YodaCh96/Reaktionsspiel/README.md

# Reaktionsspiel

## Funktionsprinzip

* Das Gerät überprüft die Reaktionszeit zweier Spieler.
* Es besitzt zwei Taster mit denen die Reaktionszeit jedes Spielers nach einem optischen Signal gemessen wird. 
* Der Spieler mit der kürzeren Reaktionszeit erhält einen Punkt. Die Punkte sind auf Anzeigen ersichtlich. Erzielt ein Spieler 9 Punkte wird ein optisches Signal ausgegeben und das Spiel ist beendet.

## Contributing

This is a personal learning project for me. Please feel free to fork this repo. Pull request to submit more programs.

## Feedback

If you find any bug or have any suggestion, please do file issues. I am graceful for any feedback and will do my best to improve this package.

## License

[MIT](LICENSE) © 2020 Ioannis Christodoulakis
