YodaCh96/Reaktionsspiel/doc/Statusbericht.md

# Statusbericht

***AP-Verantwortlicher***: Ioannis Christodoulakis, Thomas Ammann

***Datum***: 24.05.2017

## Abgeschlossen

Die Arbeitspakete «AP4. Spielerauswahl» und «AP5. Zeitmessung» wurden zusammengenommen und entwickelt. Das Zusammennehmen ermöglichte ein unkomplizierteres Entwickeln der Software. 
Der Bericht zu AP4. und AP5. ist noch nicht fertiggestellt.

## Nächste Schritte

Bis am 24.05.2017 um 18:00 Uhr wird der Bericht von AP4. und AP5. fertiggestellt.

Danach wird mit der Zusammenführung der Softwarepakete AP3. bis AP8. begonnen.

Parallel dazu wird mit der Zusammenführung der Hardwarepakete AP1. und AP2. begonnen.
