YodaCh96/Reaktionsspiel/doc/Bericht.docx

Reaktionsspiel

Gesamtdokumentation

AP-Verantwortlicher: Thomas Ammann, Ioannis Christodoulakis
Datum: 31. Mai 2017

Raumtemperatur: 24.5 °C
Revision: 01

# 1. Zusammenfassung

Es wurde, zu zweit, ein Projekt durchgeführt, in welchem ein Reaktionsspiel entwickelt wurde.

Das Reaktionsspiel vergleicht die Reaktionszeiten von zwei Spielern. Derjenige Spieler mit der kürzeren Reaktionszeit erhält einen Punkt. Auf 7-Segment-Anzeigen werden die Punktzahlen der Spieler angezeigt. Um das Spiel zu gewinnen, muss der Spieler neun Punkte erspielen.

Das Spiel wird von einem Arduino UNO Rev. 3 gesteuert. Die 7-Segment-Anzeigen werden mit BCD-UP-Counter und BCD-to-7-Segment-Converter angesteuert.

Das Projekt wurde in 10 Arbeitspakete unterteil. Diese wurden miteinander abgestimmt.
Die entworfene Feinplanung musste im Verlauf des Projektes für AP4. & AP5. erweitert werden. Dies ermöglichte eine einfachere Durchführung der beiden Arbeitspakete.

Das Projekt ist im Zeitrahmen durchgeführt worden. Die Zeitplanung konnte eingehalten werden und ist plangemäss abgeschlossen worden.

# 2. Projektgesamtziel

Das Gerät soll die Reaktionszeit zweier Spieler überprüfen. Es besitzt zwei Taster mit denen die Reaktionszeit jedes Spielers nach einem optischen Signal gemessen wird. Der Spieler mit der kürzeren Reaktionszeit erhält einen Punkt. Die Punkte sind auf Anzeigen ersichtlich. Erzielt ein Spieler 9 Punkte wird ein optisches Signal ausgegeben und das Spiel ist beendet. Das Gerät soll spielfähig aufgebaut sein. Das Projekt soll am 28.06.2017 fertiggestellt sein.

# 3. Grobplanung

Projektstruktur
Teilziel | Arbeitspakete | Aufwand
| | Schätzung | | Ist
| | Tag/e | Datum | Tag/e | Datum
Grobplanung | | ½ | 09.05.2017 | ½ | 10.05.2017
Feinplanung | | 1 | 10.05.2017 | ½ | 10.05.2017
Hardware | AP1. Eingabe | ½ | 15.05.2017 | ½ | 15.05.2017
| AP2. Ausgabe | 2 | 16.05.2017 | 1 | 16.05.2017
Software | AP3. Start | ½ | 17.05.2017 | ¼ | 17.05.2017
| AP4. Spielerauswahl | ½ | 17.05.2017 | ½ | 22.05.2017
| AP5. Zeitmessung | 2 | 23.05.2017 | ½ | 22.05.2017
| AP6. Zeitmessung-Auswertung | 1 | 23.05.2017 | ¼ | 17.05.2017
| AP7. Spielende | ½ | 24.05.2017 | ¼ | 17.05.2017
| AP.8 Neustart | ½ | 24.05.2017 | ¼ | 17.05.2017
Zusammen-Führung | AP9. Gesamtprogramm | 1 | 29.05.2017 | ½ | 29.05.2017
| AP10. Gesamt-Hardware | 1 | 29.05.2017 | ½ | 29.05.2017
| Anpassungen | 2 | / | ½ | 29.05.2017
Bericht | Gesamtdokumentation | 2 | 31.05.2017 | 2 | 31.05.2017

# 4. Feinplanung

## 4.1 Funktionsprinzip

Start

Zum Starten wird die Start-Taste gedrückt. Die Lampen der Spieler blinken drei Mal auf.

Spielerauswahl

Zu Beginn jeder Runde wird zufällig ein Spieler gewählt, welcher beginnt. Danach kommt der andere Spieler.

Es darf nicht gezeigt werden welcher Spieler beginnt!

Zeitmessung

Zufällig nach zwei bis sechs Sekunden beginnt die Zeitmessung. Das Aufleuchten einer Lampe signalisiert dem Spieler den Messungsstart. Dieser soll nun so schnell als möglich seine Taste drücken. Mit dem Drücken der Taste wird die Zeitmessung gestoppt.
Dieser Vorgang wird mit dem anderen Spieler wiederholt.

Auswertung

Die gemessenen Reaktionszeiten der Spieler werden verglichen. Der Spieler mit der kleineren Reaktionszeit erhält einen Punkt.

Spielende

Wenn ein Spieler neun Punkte erhält ist das Spiel beendet. Die Lampe des Gewinners blinkt.

Neustart

Zum Neustarten wird die Start-Taste gedrückt. Die Punkte werden zurückgesetzt.
Das Spiel kann nur nach Spielende neu gestartet werden.

## 4.2 Festlegungen

Hardwarefestlegungen

- Das Reaktionsspiel wird mit einem Arduino Uno gesteuert.
- Die Speisespannung beträgt 4.5V DC.

Softwarefestlegungen

- Die Namen des Begriffsverzeichnisses müssen verwendet werden.
- Das gesamte Programm muss kleiner als 32kByte sein.

## 4.3 Anforderungskatalog

### 4.3.1 Hardware

Arbeitspaket 1: Eingabe

Vorgaben:
Es soll für beide Spieler ein Taster zur Quittierung zur Verfügung stehen.
Mit einem Taster soll das Gerät gestartet bzw. zurückgesetzt werden.

Schnittstelleninformationen:

Speisung | Eingabe | Ausgabe
| Quittierungs-Impuls1 | Quittierungs-Signal1
4.50V DC | Quittierungs-Impuls2 | Quittierungs-Signal2
| Start-Impuls | Start-Signal

Arbeitspaket 2: Ausgabe

Vorgaben:
Die Punktzahlen der Spieler sollen auf Anzeigen ersichtlich sein.
Jeder Spieler besitzt eine optische Meldung, die den Beginn der Zeitmessung signalisiert.
Jeder Spieler besitzt eine optische Meldung, die signalisiert, wer gewonnen hat.

Erweiterungen:
Die Punktzahl der Spieler wird aus je einem Controllerausgang bestimmt.
Die Punktzahlen werden einstellig ausgegeben.

Schnittstelleninformationen:

Speisung | Eingabe | Ausgabe
| Punktzahl-Signal1 | Punktzahl1
| Punktzahl-Signal2 | Punktzahl2
4.50V DC | Optische-Meldung-Signal1 | Optische Meldung1
| Optische-Meldung-Signal2 | Optische Meldung2
| Reset-Signal (aktiv LOW)

### 4.3.2 Software

Arbeitspaket 3: Start

Vorgaben:
Zum Starten wird ein Start-Signal benötigt. Wenn das Programm startet soll ein optisches Start-Signal auftreten. Dieses Blinkt drei Mal.

Schnittstelleninformationen:

Eingabe | Ausgabe
Start-Signal | Optische Meldung1
| Optische Meldung2

Arbeitspaket 4: Spielerauswahl

Vorgaben:
Zu Beginn jeder Runde wird zufällig ein Spieler gewählt, welcher beginnt. Danach kommt der andere Spieler.

Schnittstelleninformationen:

Eingabe | Ausgabe
/ | /

Arbeitspaket 5: Zeitmessung

Vorgaben:
Die Reaktionszeit wird zwischen dem optischen Zeitmessung-Start-Signal und dem Quittierungs-Signal gemessen.

Erweiterungen:
Um die Reaktion richtig zu testen wird die Reaktionszeitmessung zufällig 1 bis 5 Sekunden verspätet gestartet.

Schnittstelleninformationen:

Eingabe | Ausgabe
Quittierungs-Signal1 | Reaktionszeit1
| Reaktionszeit2
Quittierungs-Signal2 | Optische Meldung1
| Optische Meldung2

Arbeitspaket 6: Zeitmessung-Auswertung

Vorgaben:
Die Reaktionszeiten der Spieler werden verglichen. Der Spieler mit der kürzeren Reaktionszeit erhält einen Punkt.

Erweiterungen:
Die Punktzahl der Spieler wird aus je einem Controllerausgang bestimmt. Das Punktzahl- Signal ist ein HIGH-Impuls, welcher auftritt, wenn um die Punktzahl um einen Punkt erhöht werden soll.

Schnittstelleninformationen:

Eingabe | Ausgabe
Reaktionszeit1 | Punktzahl-Signal1
| Punktzahl-Signal2
Reaktionszeit2 | Punktzahl1
| Punktzahl2

Arbeitspaket 7: Spielende

Vorgaben:
Das Spiel ist beendet, sobald ein Spieler neun Punkte erhalten hat. Die optische Meldung «Gewinner» des Spielers geht an.

Erweiterungen:
Die optische Meldung «Gewinner» soll leuchten. Wenn die optische Meldung «Gewinner» ausgegeben wird soll ist Spielende abgeschlossen.

Schnittstelleninformationen:

Eingabe | Ausgabe
Punktzahl-Signal1 | Optische Meldung1
Punktzahl-Signal2 | Optische Meldung2

Arbeitspaket 8: Neustart

Vorgaben:
Nachdem das Spiel beendet wurde, kann das dieses mit einem Start-Signal zurückgesetzt werden.

Schnittstelleninformationen:

Eingabe | Ausgabe
Punktzahl1 | Reset-Signal (aktiv LOW)
| Punktzahl-Signal1
Punktzahl2 | Punktzahl-Signal2
| Optische Meldung1
| Optische Meldung2

### 4.3.3 Zusammenführung

Arbeitspaket 9: Gesamtprogramm

Vorgaben:
Die AP3. Bis AP6. werden zum Gesamtprogramm zusammengeführt.
Das Programm soll wie in der Funktionsbeschreibung ablaufen.
(siehe «Funktionsbeschreibung»)

Schnittstelleninformationen:

Eingabe | Ausgabe
Quittieruns-Signal1 | Punktzahl-Signal1
Quittieruns-Signal2 | Punktzahl-Signal2
Start-Signal | Optische Meldung1
| Optische Meldung2
| Reset-Signal (aktiv LOW)

Arbeitspaket 10: Gesamt-Hardware

Vorgaben:
Die gesamte Hardware soll zusammengeführt werden.

Schnittstelleninformationen:

Eingabe | Ausgabe
Quittierungs-Impuls1 | Quittierungs-Signal1
Quittierungs-Impuls2 | Quittierungs-Signal2
Start-Impuls | Start-Signal
Punktzahl-Signal1 | Punktzahl1
Punktzahl-Signal2 | Punktzahl2
Optische-Meldung-Signal1 | Optische Meldung1
Optische-Meldung-Signal2 | Optische Meldung2
Reset-Signal (aktiv LOW)

### 4.3.4 Erweiterung Arbeitspaket 4. und Arbeitspaket 5.

Um das Arbeitspaket 4 und das Arbeitspaket 5 miteinander abzustimmen, wurden die Schnittstelleninformationen erweitert.

Arbeitspaket 4: Spielerauswahl

Eingabe | Ausgabe
| Spieler1
| Spieler2
/ | Zeitmessungstart1
| Zeitmessungstart2
| EingangSpieler1
| EingangSpieler2

Variable | Speicher-Name
Spieler1 | Spieler[0]
Spieler2 | Spieler[1]
Zeitmessungstart1 | Zms[0]
Zeitmessungstart2 | Zms[1]
EingangSpieler1 | EingangSpieler[0]
EingangSpieler2 | EingangSpieler[1]

Arbeitspaket 5: Zeitmessung

Eingabe | Ausgabe
Quittierungs-Signal1 | Reaktionszeit1
Quittierungs-Signal2
Zeitmessungstart1 | Reaktionszeit2
Zeitmessungstart2
EingangsSpieler1 | Optische Meldung1
EingangsSpieler2
Spieler1 | Optische Meldung2
Spieler2

Variable | Speicher-Name
Spieler1 | Spieler[0]
Spieler2 | Spieler[1]
Zeitmessungstart1 | Zms[0]
Zeitmessungstart2 | Zms[1]
EingangSpieler1 | EingangSpieler[0]
EingangSpieler2 | EingangSpieler[1]

### 4.3.5 Begriffsverzeichnis

Eingabe | Speicher-Name | Pin-Name | Pin | Datentyp
Start-Signal | St_Si | S_S | 3 | bool
Quittieruns-Signal1 | Qu_Si1 | Q_S1 | 4 | char
Quittieruns-Signal2 | Qu_Si2 | Q_S2 | 5 | char

Ausgabe | Speicher-Name | Pin-Name | Pin | Datentyp
Punktzahl-Signal1 | Pu_Si1 | P_S1 | 6 | char
Punktzahl-Signal2 | Pu_Si2 | P_S2 | 7 | char
Optische Meldung1 | Op_Me1 | O_M1 | 8 | char
Optische Meldung2 | Op_Me2 | O_M2 | 9 | char
Reset-Signal (aktiv LOW) | Re_Si | R_S | 10 | char

Variable | Speicher-Name | Datentyp
Punktzahl1 | Pu_Za1 | char
Punktzahl2 | Pu_Za2 | char
Reaktionszeit1 | Re_Ze1 | char
Reaktionszeit2 | Re_Ze2 | char
Spieler1 | Spieler[0] | char
Spieler2 | Spieler[1] | char
Zeitmessungstart1 | Zms[0] | char
Zeitmessungstart2 | Zms[1] | char
EingangSpieler1 | EingangSpieler[0] | char
EingangSpieler2 | EingangSpieler[1] | char

# 5. Arbeitspakete

## 5.1 Arbeitspaket 1: Eingabe

### 5.1.1 Zusammenfassung

Es wurde eine funktionsfähige Schaltung zur Erzeugung dreier digitaler Signale entwickelt. Mit einem Tastendruck wird das jeweilige Signal logisch HIGH.

### 5.1.2 Aufgabenstellung

Der physikalische Druck soll in eine digitale Spannung umgewandelt werden. Es soll für beide Spieler ein Taster zur Quittierung zur Verfügung stehen. Mit einem Taster soll das Gerät gestartet werden.

### 5.1.3 Vorgaben

Schnittstelleninformationen
Speisung: 5V DC
Eingänge: Quittierungs-Impuls (Spieler1 und Spieler2, Druck), Start-Signal (Druck)
Ausgänge: Quittierungs-Signale (Spieler1 und Spieler2),
Start-Signal

### 5.1.4 Blockschaltbild

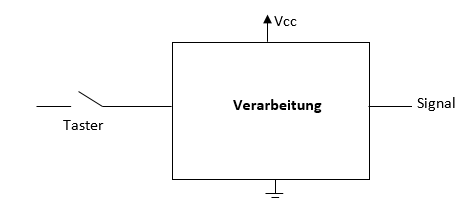
[picture p1: figure]

Start-Signal

Quittierungs-Signal 1

Quittierungs-Signal 2

Quittierungs-Impuls1

Quittierungs-Impuls2

Start-Signal (Druck)

Abbildung 1, Blockschaltbild

### 5.1.5 Lösungsansätze

Mit einem Taster und einem Pull-Down-Widerstand wird die digitale Spannung erzeugt.

### 5.1.6 Berechnungen

Gegebene Werte:

V_(cc) = 5.00V

R_1 = R_2 =R_3 = 10.0kΩ

Berechnungen:

I_(Max.AM1) =(3*V_(cc))/(R_1)=(3*5V)/(10kΩ)= 1.50 mA

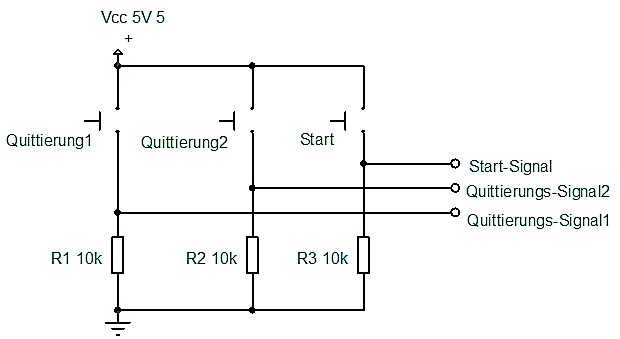
[picture p2: figure]

### 5.1.7 Schaltung

Abbildung 2, Schaltung

Es wurde die obige Schaltung entwickelt. (Abb.2)

### 5.1.8 Messungen

Abbildung 3, Messschaltung

Quittierung1 | Quittierung2 | Start | AM1 in mA | VM1 in V | VM2 in V | VM3 in V
0 | 0 | 0 | 0.01 | 0 | 0 | 0
gedrückt | 0 | 0 | 0.51 | 5 | 0 | 0
0 | gedrückt | 0 | 0.50 | 0 | 5 | 0
0 | 0 | gedrückt | 0.50 | 0 | 0 | 5
gedrückt | gedrückt | gedrückt | 1.52 | 5 | 5 | 5

### 5.1.9 Verwendete Geräte

Multimeter: Agilent U1242A, BERUF Zug 03542

Speisegerät: DC Power Supply DF1730SB3A, BERUF Zug 03460

Breadboard: Besitzer Thomas Ammann

### 5.1.10 Schlussfolgerung

Es wurde eine funktionsfähige Schaltung entwickelt.

Die Ausgänge sind logisch LOW bis der jeweilige Taster gedrückt wird. Dabei wird der Ausgang logisch HIGH.

## 5.2 Arbeitspaket 2: Ausgabe

### 5.2.1 Zusammenfassung

Es wurde eine Schaltung entwickelt, welche die Punkzahlen der Spieler 1 und 2 auf je einer
7-Segmentanzeigen anzeigt. Mit zwei LEDs werden die optische Signale der Spieler angezeigt.

### 5.2.2 Aufgabenstellung

Es muss eine Teilschaltung entwickelt werden, die die Punktzahlen der Spieler 1 und 2 auf Anzeigen anzeigt. Jeder Spieler besitzt eine optische Meldung, die den Beginn der Zeitmessung signalisiert. Jeder Spieler besitzt eine optische Meldung, die signalisiert, wer gewonnen hat.

### 5.2.3 Vorgaben

Erweiterungen:
Die Punktzahl der Spieler wird aus je einem Controllerausgang bestimmt.
Die Punktzahlen werden einstellig ausgegeben.

Schnittstelleninformationen:
Speisung: 5V DC
Eingänge: Punktzahl-Signale (Spieler1 und Spieler2),
Zeitmessung-Start-Signale (Spieler1 und Spieler2),
Gewinner-Signale (Spieler1 und Spieler2),
Beginn-Signal (Spieler1 und Spieler2), Reset-Signal
Ausgänge: Punktzahlen (einstellig, Spieler1 und Spieler2),
optische Meldungen für «Zeitmessung-Start» (Spieler1 und Spieler2),
optische Meldungen für «Gewinner» (Spieler1 und Spieler2),
optisches Beginn-Signal (Spieler1 und Spieler2)

### 5.2.4 Blockschaltbild

optische Meldung Spieler 1

Vcc 5V

PZ-Signal Spieler 2

PZ-Signal Spieler 1

Verarbeitung

ZS-Signal Spieler 2

ZS-Signal Spieler 1

Punktzahl Spieler 1

GW-Signal Spieler 2

GW-Signal Spieler 1

Beginn-Signal Spieler 2

Beginn-Signal Spieler 1

Punktzahl Spieler 2

Reset-Signal

optische Meldung Spieler 2

- ZS-Signale Spieler 1,2: Zeitmessung-Start-Signale Spieler 1,2
- PZ-Signale Spieler 1,2: Punktzahl-Signale Spieler 1,2
- GW-Signale Spieler 1,2: Gewinner-Signale Spieler 1,2

### 5.2.5 Berechnungen

Für LEDs müssen immer Vorwiderstände verwendet werden, welche dafür sorgen, dass an der LED nur die zulässige Spannung anliegt. Durch diese Vorwiderstände wird auch der Strom I durch die LEDs begrenzt, sodass den Strom nicht über den maximalen zulässigen Strom der LED ansteigt. Für I nehme ich in meinen Berechnungen den Erfahrungswert 7mA.

Kennwerte der roten LED:

UF = 2.1V (Datenblatt, Quellenverzeichnis)

I = 7mA (Erfahrungswert)

*¹U0 (Speisung)= 5V (Vorgabe)

R_(1,2) = (U_0 - U_F)/I= (5V-2.1V)/(7mA)= 414Ω

Aus unserer E-24 Widerstandsreihe haben wir einen R1,2=430 Ω gewählt.

I= (U_0 - U_F)/(R_V)= (5V-2.1V)/(430 Ω)= 6.74 mA

*¹ 5V Betriebsspannung von Arduino UNO Rev.3

Pull-Down Widerstände:

Da recht hohe Frequenzen zum Einsatz kommen die sich in unmittelbarer Nähe der Eingänge befinden ist es notwendig diese Eingänge mit einem definierten Potential zu versehen. Klassischer Weise wird ein Widerstand verwendet, welcher zum Beispiel auf Masse gelegt wird. Ein so genannter Pull Down Widerstand. Ich habe für Pull-down Widerstände R17=R18=R19=10kΩ entschieden.

Vorwiderstände 7-Segment-Anzeige:

U’F = 2.1V (Datenblatt, Quellenverzeichnis)

I’ = 5mA (Erfahrungswert)

*¹U0 (Speisung)= 5V (Vorgabe)

R_(3-16) = (U_0 - U'_F)/(I')= (5V-2.1V)/(5mA)= 580Ω

Aus unserer E-24 Widerstandsreihe haben wir einen R3-16=620 Ω gewählt.

I'= (U_0 - U'_F)/(R_(3-16))= (5V-2.1V)/(620 Ω)= 4.67 mA

### 5.2.6 Schaltung

### 5.2.7 Messung

Clock-Signal | 7-Segment Zahl Spieler 1 | 7-Segment Zahl Spieler 2
0 | 0 | 0
1 | 1 | 1
0 | 1 | 1
1 | 2 | 2
0 | 2 | 2
1 | 3 | 3
0 | 3 | 3
1 | 4 | 4
0 | 4 | 4
1 | 5 | 5
0 | 5 | 5
1 | 6 | 6
0 | 6 | 6
1 | 7 | 7
0 | 7 | 7
1 | 8 | 8
0 | 8 | 8
1 | 9 | 9
0 | 9 | 9
1 | 0 | 0

### 5.2.8 Verwendete Geräte und Elektrokomponente

Digitrainer 6 BERUF Zug 00878 | 2x 7-Segment Anzeigen | 2x BCD-Decoder 74HC4511
2x LEDs rot 5mm | 2x 74HC162 | 3x Taster
2x R1=R2=430Ω | 14x R3-R16=620Ω | 3x Pull-Down Widerstände R17-R19=10kΩ

### 5.2.9 Schlussfolgerung

Die entwickelte Schaltung erfüllt die Vorgaben (siehe 3. Vorgaben/Seite 14).
Sie wurde mit einem Digitrainer komplett getestet.

## 5.3 Arbeitspaket 3: Start

### 5.3.1 Zusammenfassung

Es wurde ein Software-Programm entwickelt, welches ein Start-Signal benötigt. Wenn das Programm startet, blinken zwei LEDs drei Mal.

### 5.3.2 Aufgabenstellung

Zum Starten wird ein Start-Signal benötigt. Wenn das Programm startet soll ein optisches Start-Signal auftreten. Dieses Blinkt drei Mal.

Schnittstelleninformationen
Eingänge: Start-Signal (aktiv LOW)
Ausgänge: Beginn-Signal (Spieler1 und Spieler2)

### 5.3.3 Begriffsverzeichnis

Eingabe | Speicher-Name | Pin-Name | Pin
Start-Signal | St_Si | S_S | 3

Ausgabe | Speicher-Name | Pin-Name | Pin
Optische Meldung1 | Op_Me1 | O_M1 | 8
Optische Meldung2 | Op_Me2 | O_M2 | 9

### 5.3.4 Struktogramm

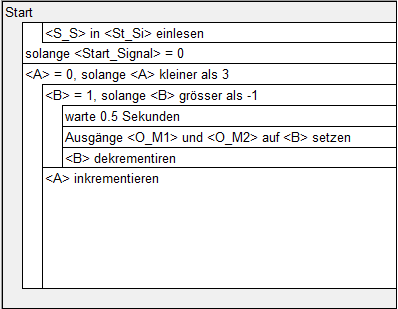
[picture p3: figure]

Abbildung 2, Struktogramm

### 5.3.5 Programm–Code

Um eine Variable zu erstellen, müssen wir diese zuerst deklarieren. Wir haben für die Variablen
Start-Signal, A und B den Datentyp char gewählt, da die Variablen nicht mehr Speicherplatz benötigen (1 Byte).

bool St_Si ; // Variablen

char A,

B;

Die Pin-Nummern der Ein- und Ausgänge sind den Pin-Namen gespeichert. Diese sind unveränderbar.

const char S_S = 3, // Konstanten

O_M1 = 8,

O_M2 = 9;

setup() wird einmalig beim Einschalten des Arduino ausgeführt. Dort definieren wir mit der Funktion pinMode(), ob die digitalen Pins Ein- oder Ausgänge sind.

void setup() { // I/O

pinMode (S_S, INPUT); // Eingaenge

pinMode (O_M1, OUTPUT); // Ausgaenge

pinMode (O_M2, OUTPUT);

}

loop() wird wiederholt ausgeführt. In der Funktion wird das Hauptprogramm ausgeführt.
Die do-while-Schleife liest den Digitalwert am Eingang «S_S» ein und speichert ihn in «St_Si». Danach wartet das Programm 50ms, bevor es überprüft, ob «St_Si» 0 entspricht. Trifft dies zu, wird die Schleife wiederholt.

void loop() { // Hauptprogramm

do { // Start-Signal einlesen

St_Si = digitalRead(S_S);

delay (50);

} while (St_Si == 0);

Die erste for-Schleife wird dreimal durchgeführt. Die zweite Schleife wird zweimal durchgeführt. Im erstem Durchlauf werden die Ausgänge «O_M1» und «O_M2» eingeschaltet. Im zweiten Durchlauf werden diese ausgeschaltet. Die delay()–Funktion lässt den Arduino die Ausführung des Programms für eine gewisse Zeitspanne anhalten. Damit wird der Logikwechsel der Ausgänge verlangsamt.

for (A = 0; A < 3; A++) { // Optische Meldung

for (B = 1; B > -1; B--) {

delay (500);

digitalWrite (O_M1, B);

digitalWrite (O_M2, B);

}

}

}

### 5.3.6 Schlussfolgerung

Das entwickelte Software-Programm erfüllt die Anforderungen der Aufgabenstellung.
(2. Aufgabenstellung/Seite 19).

## 5.4 Arbeitspaket 4: Spielerauswahl

### 5.4.1 Zusammenfassung

Es wurde ein Software-Programm entwickelt, welches zufällig einen Spieler wählt. Dieser beginnt die Runde.

### 5.4.2 Aufgabenstellung

Zu Beginn jeder Runde wird zufällig ein Spieler gewählt, welcher beginnt. Danach kommt der andere Spieler.

Schnittstelleninformationen

Eingabe | Ausgabe
/ | Spieler1
/ | Spieler2
/ | Zeitmessungstart1
/ | Zeitmessungstart2
/ | EingangSpieler1
/ | EingangSpieler2

Begriffserklärung

Variable | Speicher-Name
Spieler1 | Spieler[0]
Spieler2 | Spieler[1]
Zeitmessungstart1 | Zms[0]
Zeitmessungstart2 | Zms[1]
EingangSpieler1 | EingangSpieler[0]
EingangSpieler2 | EingangSpieler[1]

### 5.4.3 Struktogramm

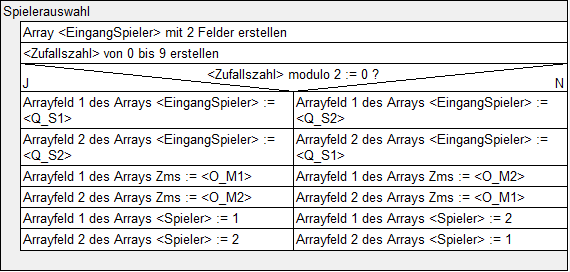
[picture p4: figure]

### 5.4.4 Programm–Code

Um eine Variable zu erstellen, müssen wir diese zuerst deklarieren. Wir haben für die Variablen
den Datentyp char gewählt, da die Variablen nicht mehr Speicherplatz benötigen (1 Byte).

char EingangSpieler[2], // Variablen

Zms[2],

Spieler[2];

unsigned long Zufallszahl;

Die Pin-Nummern der Ein- und Ausgänge sind den Pin-Namen gespeichert. Diese sind unveränderbar.

const char Q_S1 = 4, // Konstanten

Q_S2 = 5,

O_M1 = 8,

O_M2 = 9;

setup() wird einmalig beim Einschalten des Arduino ausgeführt. Mit der Funktion randomSeed() wird der Analogeingang definiert, welcher für die Erstellung des «zufälligen» Werts verwendet wird. Dieser Eingang muss logisch unbestimmt sein, darf also nicht angeschlossen sein.

void setup() { // I/O

randomSeed(analogRead(0)); // Der analog-Input 0 darf nicht angeschlossen werden.

}

loop() wird wiederholt ausgeführt. In der Funktion wird das Hauptprogramm ausgeführt.
Die Funktion random() generiert einen «zufälligen» Wert von 0 bis 99. Dieser wird in «Zufallszahl» gespeichert. Mit der Variable «Zufallszahl» wird einem modulo-2-Rechnung durchgeführt. Ist das Ergebnis 0 beginnt Spieler 1. Ist das Ergebnis 1 beginnt Spieler 2.

void loop() { // Hauptprogramm

Zufallszahl = random(100);

if(Zufallszahl % 2 == 0){ // Auswertung

EingangSpieler[0] = Q_S1;

EingangSpieler[1] = Q_S2;

Zms[0] = O_M1;

Zms[1] = O_M2;

Spieler[0] = 1;

Spieler[1] = 2;

}

else{

EingangSpieler[0] = Q_S2;

EingangSpieler[1] = Q_S1;

Zms[0] = O_M2;

Zms[1] = O_M1;

Spieler[0] = 2;

Spieler[1] = 1;

}

}

### 5.4.5 Schlussfolgerung

Das entwickelte Software-Programm erfüllt die Anforderungen der Aufgabenstellung
(2. Aufgabenstellung/Seite 21).

## 5.5 Arbeitspaket 5: Zeitmessung

### 5.5.1 Zusammenfassung

Es wurde ein Software-Programm entwickelt, welches die Reaktionszeit der beiden Spieler misst.

### 5.5.2 Aufgabenstellung

Die Reaktionszeit wird zwischen dem optischen Zeitmessung-Start-Signal und dem Quittierungs-Signal gemessen.

Um die Reaktion richtig zu testen wird die Reaktionszeitmessung zufällig 1 bis 5 Sekundenverspätet gestartet.

Schnittstelleninformationen

Eingabe | Ausgabe
Quittierungs-Signal1 | Reaktionszeit1
Quittierungs-Signal2 | Reaktionszeit2
Zeitmessungstart1 | Optische Meldung1
Zeitmessungstart2 | Optische Meldung2
EingangsSpieler1
EingangsSpieler2
Spieler1
Spieler2

Begriffserklärung

Variable | Speicher-Name
Spieler1 | Spieler[0]
Spieler2 | Spieler[1]
Zeitmessungstart1 | Zms[0]
Zeitmessungstart2 | Zms[1]
EingangSpieler1 | EingangSpieler[0]
EingangSpieler2 | EingangSpieler[1]
Reaktionszeit1 | Re_Ze1
Reaktionszeit2 | Re_Ze2

Eingabe | Speicher-Name | Pin-Name | Pin
Quittieruns-Signal1 | Qu_Si1 | Q_S1 | 4
Quittieruns-Signal2 | Qu_Si2 | Q_S2 | 5

Ausgabe | Speicher-Name | Pin-Name | Pin
Optische Meldung1 | Op_Me1 | O_M1 | 8
Optische Meldung2 | Op_Me2 | O_M2 | 9

### 5.5.3 Struktogramm

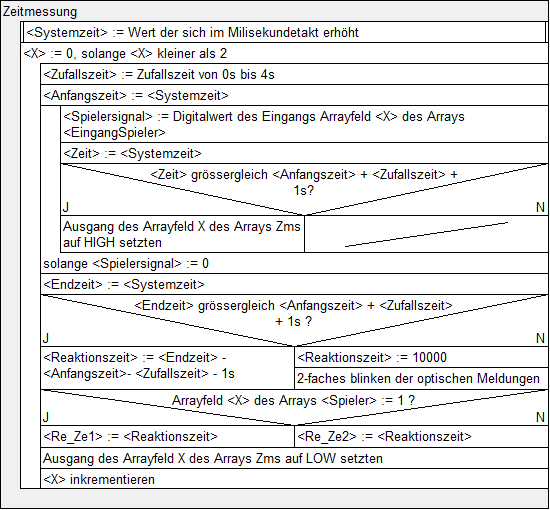
[picture p5: figure]

### 5.5.4 Programm – Code

Zunächst werden die Variablen definiert.

char X, // Variablen

Spielersignal,

Zms[2], // Zeitmessungstart

Spieler[2];

int Zufallszeit,

Re_Ze1,

Re_Ze2;

unsigned long Anfangszeit, // Anfangszeit der Zeitmessung

Endzeit, // Endzeit der Zeitmessung

Zeit;

Die Pin-Nummern der Ein- und Ausgänge sind den Pin-Namen gespeichert. Diese sind unveränderbar.

const char Q_S1 = 4, // Konstanten

Q_S2 = 5,

O_M1 = 8,

O_M2 = 9;

setup() wird einmalig beim Einschalten des Arduino ausgeführt. Dort definieren wir mit der Funktion pinMode(), ob die digitalen Pins Ein- oder Ausgänge sind. Mit der Funktion randomSeed() wird der Analogeingang definiert, welcher für die Erstellung des «zufälligen» Werts verwendet wird. Dieser Eingang muss logisch unbestimmt sein, darf also nicht angeschlossen sein.

void setup() { // I/O

pinMode(Q_S1, INPUT); // Eingaenge

pinMode(Q_S2, INPUT);

pinMode(O_M1, OUTPUT); // Ausgaenge

pinMode(O_M2, OUTPUT);

randomSeed(analogRead(0)); // Der analogInput 0 darf nicht angeschlossen werden.

}

loop() wird wiederholt ausgeführt. In der Funktion wird das Hauptprogramm ausgeführt.
Die for-Schleife wird zweimal durchgeführt. Die Funktion random() erzeugt einen «zufälligen» Wert von 0 bis 4000. Die Funktion millis() erzeugt einen Wert, welcher jede Millisekunde inkrementiert wird. «Anfangszeit» entspricht dem Wert von millis().

void loop() { // Hauptprogramm

for(X = 0; X < 2; X++){ // Auswertung

Zufallszeit = random(4001);

Anfangszeit = millis();

«Zeit» entspricht dem aktuellen Wert von millis(). Die if-Verzweigung prüft, ob «Zeit» grössergleich «Anfangszeit» + «Zufallszeit» + 1000 entspricht. Trifft dies zu wird ein Zeitmessungsstart-Signal ausgegeben. Die do-while-Schleife wird wiederholt solange «Spielersignal» 0 entspricht. Danach wird der Wert von millis() «Endzeit» zugeordnet.

do{

Spielersignal = digitalRead(EingangSpieler[X]);

Zeit = millis();

if(Zeit >= Anfangszeit + Zufallszeit + 1000){

digitalWrite(Zms[X], HIGH);

}

}while(Spielersignal == 0);

Endzeit = millis();

Die if-Verzweigung prüft, ob «Endzeit» grössergleich «Anfangszeit» + «Zufallszeit» + 1000. Trifft dies zu wird die Reaktionszeit ausgerechnet und in «Reaktionszeit» gespeichert. Trifft der Vergleich nicht zu wird «Reaktionszeit» auf 10000 (10s) gesetzt. Dabei werden zwei optische Signale ausgegeben.

if(Endzeit >= Anfangszeit + Zufallszeit + 1000){

Reaktionszeit = Endzeit - Anfangszeit - Zufallszeit - 1000;

}

else{

Reaktionszeit = 10000;

digitalWrite(O_M1, HIGH);

digitalWrite(O_M2, HIGH);

delay(300);

digitalWrite(O_M1, LOW);

digitalWrite(O_M2, LOW);

delay(300);

digitalWrite(O_M1, HIGH);

digitalWrite(O_M2, HIGH);

delay(300);

digitalWrite(O_M1, LOW);

digitalWrite(O_M2, LOW);

}

Die if-Verzweigung prüft welchem Spieler «Reaktionszeit» zuzuordnen ist und speichert diese in die entsprechende Variable. Danach wird das Zeitmessungsstart-Signal auf logisch LOW gesetzt.

if(Spieler[X] = 1){

Re_Ze1 = Reaktionszeit;

}

else{

Re_Ze2 = Reaktionszeit;

}

digitalWrite(Zms[X], LOW);

}

}

### 5.5.5 Schlussfolgerung

Das entwickelte Software-Programm erfüllt die Anforderungen der Aufgabenstellung.

## 5.6 Arbeitspaket 6: Zeitmessung-Auswertung

### 5.6.1 Zusammenfassung

Es wurde ein Software-Programm entwickelt, welches die Reaktionszeiten zweier Spieler vergleicht und auswertet. Derjenige Spieler mit der kleineren Reaktionszeit erhält einen Punkt.

### 5.6.2 Aufgabenstellung

Die Reaktionszeiten der Spieler werden verglichen. Der Spieler mit der kürzeren Reaktionszeit erhält einen Punkt.

Die Punktzahl der Spieler wird aus je einem Controllerausgang bestimmt. Das Punktzahl-Signal ist ein HIGH-Impuls, welcher auftritt, wenn die Punktzahl um einen Punkt erhöht werden soll.

Schnittstelleninformationen

Eingabe | Ausgabe
Reaktionszeit1 | Punktzahl-Signal1
Reaktionszeit2 | Punktzahl-Signal2
| Punktzahl1
| Punktzahl2

Begriffserklärung

Variable | Speicher-Name
Punktzahl1 | Pu_Za1
Punktzahl2 | Pu_Za2
Reaktionszeit1 | Re_Ze1
Reaktionszeit2 | Re_Ze2

Ausgabe | Speicher-Name | Pin-Name | Pin
Punktzahl-Signal1 | Pu_Si1 | P_S1 | 6
Punktzahl-Signal2 | Pu_Si2 | P_S2 | 7

### 5.6.3 Struktogramm

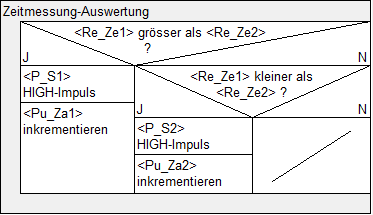
[picture p6: figure]

### 5.6.4 Programm–Code

Zunächst werden die Variablen definiert.

int Re_Ze1, // Variablen

Re_Ze2 ;

char Pu_Za1 = 0,

Pu_Za2 = 0 ;

Die Pin-Nummern der Ein- und Ausgänge sind den Pin-Namen gespeichert. Diese sind unveränderbar.

const char P_S1 = 6, // Konstanten

P_S2 = 7;

setup() wird einmalig beim Einschalten des Arduino ausgeführt. Dort definieren wir mit der Funktion pinMode(), ob die digitalen Pins Ein- oder Ausgänge sind.

void setup() { // I/O

pinMode(P_S1, OUTPUT); // Ausgaenge

pinMode(P_S2, OUTPUT);

}

loop() wird wiederholt ausgeführt. In der Funktion wird das Hauptprogramm ausgeführt.
Die if-Verzweigung prüft, ob «Re_Ze1» grösser als «Re_Ze2» ist. Trifft dies zu wird ein Punktzahl-Signal ausgegeben und die Punktzahl des ersten Spielers wird inkrementiert. Die else-if-Verzweigung prüft, ob «Re_Ze1» kleiner als «Re_Ze2» ist. Trifft dies zu wird ein Punktzahl-Signal ausgegeben und die Punktzahl des zweiten Spielers wird inkrementiert.

void loop() { // Hauptprogramm

if(Re_Ze1 > Re_Ze2){ // Auswertung

digitalWrite(P_S1, HIGH);

delay(10);

digitalWrite(P_S1, LOW);

Pu_Za2++;

}

else if(Re_Ze1 < Re_Ze2){

digitalWrite(P_S2, HIGH);

delay(10);

digitalWrite(P_S2, LOW);

Pu_Za1++;

}

### 5.6.5 Schlussfolgerung

Das entwickelte Software-Programm erfüllt die Anforderungen der Aufgabenstellung
(2. Aufgabenstellung/Seite 29).

## 5.7 Arbeitspaket 7: Spielende

### 5.7.1 Zusammenfassung

Es wurde ein Software-Programm entwickelt, welches das Spielende auswertet. Das Programm gibt eine optische Meldung aus, wenn ein Spieler neun Punkte erhält.

### 5.7.2 Aufgabenstellung

Das Spiel ist beendet, sobald ein Spieler neun Punkte erhalten hat. Die optische Meldung «Gewinner» des Spielers geht an.

Schnittstelleninformationen
Die optische Meldung «Gewinner» soll leuchten. Wenn die optische Meldung «Gewinner» ausgegeben wird soll ist Spielende abgeschlossen.

Eingabe | Ausgabe
Punktzahl-Signal1 | Optische Meldung1
Punktzahl-Signal2 | Optische Meldung2

Begriffsverzeichnis

Variable | Speicher-Name
Punktzahl1 | Pu_Za1
Punktzahl2 | Pu_Za2

Ausgabe | Speicher-Name | Pin-Name | Pin
Optische Meldung1 | Op_Me1 | O_M1 | 8
Optische Meldung2 | Op_Me2 | O_M2 | 9

### 5.7.3 Struktogramm

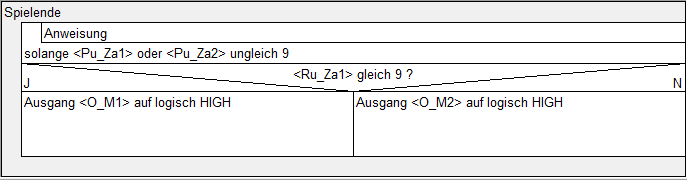
[picture p7: figure]

Abbildung 3, Struktogramm

### 5.7.4 Programm–Code

In den Variablen «Pu_Za1» und «Pu_Za1» werden die Punktzahlen der Spieler gespeichert. Da diese minimal 0 und maximal 9 sein können genügen Variablen vom Datentyp char.

char Pu_Za1, // Variablen

Pu_Za2;

Die Pin-Nummern der Ein- und Ausgänge sind den Pin-Namen gespeichert. Diese sind unveränderbar.

const char O_M1 = 8, // Konstanten

O_M2 = 9;

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

void setup () { // I/O

pinMode (O_M1, OUTPUT); // Ausgaenge

pinMode (O_M2, OUTPUT);

}

loop() wird wiederholt ausgeführt. In der Funktion wird das Hauptprogramm ausgeführt.
Die do-while-Schleife überprüft, ob «Pu-Za1» oder «Pu_Za2» 9 entspricht. Trifft dies zu, fragt die if-Verzweigung, welche der beiden Variablen 9 entspricht. Danach wird eine optische Meldung ausgegeben.

void loop() { / // Hauptprogramm

do{ // Auswertung

// Spielerauswahl, Zeitmessung, Zeitmessung-Auswertung

}while(Pu_Za1 == 9 || Pu_Za2 == 9);

if(Pu_Za1 == 9){

digitalWrite(O_M1, HIGH);

}

else{

digitalWrite(O_M2, HIGH);

}

}

### 5.7.5 Schlussfolgerung

Das entwickelte Software-Programm erfüllt die Anforderungen der Aufgabenstellung.
(2. Aufgabenstellung/ Seite 31).

## 5.8 Arbeitspaket 8: Neustart

### 5.8.1 Zusammenfassung

Es wurde ein Software-Programm entwickelt, welches einen Neustart durchführt. Das Programm setzt die Punktzahlen und die Anzeigen der Spieler auf 0 zurück.

### 5.8.2 Aufgabenstellung

Nachdem das Spiel beendet wurde, kann das dieses mit einem Start-Signal zurückgesetzt werden.

Schnittstelleninformationen

Eingabe | Ausgabe
Punktzahl1 | Reset-Signal (aktiv LOW)
Punktzahl2 | Punktzahl-Signal1
| Punktzahl-Signal2
| Optische Meldung1
| Optische Meldung2

Begriffsverzeichnis

Ausgabe | Speicher-Name | Pin-Name | Pin
Punktzahl-Signal1 | Pu_Si1 | P_S1 | 6
Punktzahl-Signal2 | Pu_Si2 | P_S2 | 7
Optische Meldung1 | Op_Me1 | O_M1 | 8
Optische Meldung2 | Op_Me2 | O_M2 | 9
Reset-Signal (aktiv LOW) | Re_Si | R_S | 10

Variable | Speicher-Name
Punktzahl1 | Pu_Za1
Punktzahl2 | Pu_Za2

### 5.8.3 Struktogramm

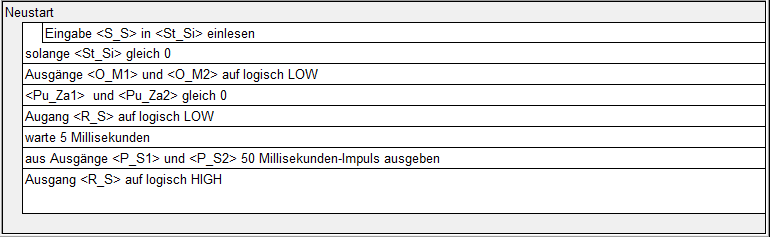
[picture p8: figure]

### 5.8.4 Programm–Code

Um eine Variable zu erstellen, müssen wir diese zuerst deklarieren. Wir haben für die Variablen
Start-Signal, Punktzahl1 und B den Datentyp char gewählt, da die Variablen nicht mehr Speicherplatz benötigen (1 Byte).

char St_Si, // Variablen

Pu_Za1,

Pu_Za2;

Die Pin-Nummern der Ein- und Ausgänge sind den Pin-Namen gespeichert. Diese sind unveränderbar.

const char S_S = 3, // Konstanten

P_S1 = 6,

P_S2 = 7,

O_M1 = 8,

O_M2 = 9,

R_S = 10;

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

void setup () { // I/O

pinMode (S_S, INPUT); // Eingaenge

pinMode (P_S1, OUTPUT); // Ausgaenge

pinMode (P_S2, OUTPUT);

pinMode (O_M1, OUTPUT);

pinMode (O_M2, OUTPUT);

pinMode (R_S, OUTPUT);

}

loop() wird wiederholt ausgeführt. In der Funktion wird das Hauptprogramm ausgeführt.
Der Inhalt der do-while-Schleife liest den Digitalwert am Eingang «S_S» ein und speichert ihn in «St_Si». Dies wird solange ausgeführt, bis «St_Si» 0 entspricht. Danach werden die optischen Meldungen ausgeschaltet und die Punktzahlen und die Anzeigen auf 0 zurückgesetzt.

void loop() { // Hauptprogramm

do{ // Auswertung

St_Si = digitalRead(S_S);

}while (St_Si == 0);

digitalWrite (O_M1, LOW); // Optische Meldung ausschalten

digitalWrite (O_M2, LOW);

Pu_Za1 = 0; // Punktzahl1 zurücksetzten

Pu_Za2 = 0; // Punktzahl2 zurücksetzten

DigitalWrite (R_S, LOW); // Anzeigen zurücksetzten

delay (5);

digitalWrite (P_S1, HIGH);

digitalWrite (P_S2, HIGH);

delay (50);

digitalWrite (P_S1, LOW);

digitalWrite (P_S2, LOW);

digitalWrite (R_S, HIGH);

}

### 5.8.5 Schlussfolgerung

Das entwickelte Software-Programm erfüllt die Anforderungen der Aufgabenstellung
(2. Aufgabenstellung/ Seite 33).

## 5.9 Gesamt-Hardware

Die Zusammenführung der Hardware verlief problemlos.

## 5.10 Gesamt-Software

Anpassungen

Bei der Zusammenführung der Arbeitspakete AP3. bis AP8. wurden Änderungen vorgenommen.
Das Programm besitzt nun drei Unterprogramme («Start_Taster()»,«Blinken()»,«Zuruecksetzung()»). Diese verkürzen den Programm-Code.

/* Projektnamen: Reaktionsspiel

* Dateinamen: Gesamtprogramm_Reaktionsspiel.ino

* Entwickler: T. Ammann, I. Christodoulakis

* Datum: 29.05.2017

* Ort: 6301 Zug, CH

* Entwicklungsschritt: Zusammenführung, 29.05.2017

* Formatierung, 29.05.2017

* Erweiterung um Unterprogramm
* "Start_Taster", "Blinken" &

* "Zuruecksetzung"

* Letztes Aenderungsdatum: 29.05.2017

*/

/* Variablen ------------------------------------------------------------------- */

bool St_Si; // Start-Signal

char EingangSpieler[2],

Spieler[2],

Zms[2],

Spielersignal;

char Pu_Za1 = 0, // Punktzahl1

Pu_Za2 = 0; // Punktzahl2

char a, // fuer for-Schleifen {

b,

c,

x,

y; // }

unsigned long Anfangszeit, // Anfangszeit der Zeitmessung

Endzeit, // Endzeit der Zeitmessung

Zeit,

Zufallszahl, // zufaellig generierte Zahl

Re_Ze1, // Reaktionszeit1

Re_Ze2, // Reaktionszeit2

Zufallszeit; // zufaellig generierte Zeit (0 <= Wert < 4001)

/* -------------------------------------------------------------------------------- */

Die Variable «St_Si» ist vom Datentyp «bool», da sie nur die Werte 0 & 1 besitzen kann.

Die Variablen vom Daten-Typ «char», da sie nur einstellige Dezimal-Werte annehmen können.

Die Variablen vom Datentyp «unsigned long» speichern Zeiten, welche von der Funktion «millis()» bestimmt werden. «millis()» gibt den Wert in «unsigned long» aus.

/* Konstanten ---------------------------------------------------------------- */

const char S_S = 3, // Eingaenge {

Q_S1 = 4,

Q_S2 = 5, // }

P_S1 = 6, // Ausgaenge {

P_S2 = 7,

O_M1 = 8,

O_M2 = 9,

R_S = 10; // }

/* -------------------------------------------------------------------------------- */

/* Setup ----------------------------------------------------------------------- */

void setup(){

/* Eingaenge ----------------------------------------------------------------- */

pinMode(S_S, INPUT);

pinMode(Q_S1, INPUT);

pinMode(Q_S2, INPUT);

/* Ausgaenge ----------------------------------------------------------------- */

pinMode(P_S1, OUTPUT);

pinMode(P_S2, OUTPUT);

pinMode(O_M1, OUTPUT);

pinMode(O_M2, OUTPUT);

pinMode(R_S, OUTPUT);

/* Pin fuer Zufallszahl ------------------------------------------------------ */

randomSeed(analogRead(0)); // analogPin0 nicht anschliessen!

}

/* -------------------------------------------------------------------------------- */

Die Konstanten sind im Datentyp «char», da sie einfache Werte (Charakter) speichern.

Im Setup werden die Ein- und die Ausgänge definiert.

Mit der Funktion «randomSeed()» wird die Referenz für die Zufallszahlgenerierung definiert.

/* Unterprogrammdeklaration ------------------------------------------ */

// Start-Signal einlesen

void Start_Taster(char Start_Pin);

// Optische Meldung ein- & ausschalten

void Blinken(void);

//Anzeigen zuruecksetzten

void Zuruecksetzung(char Punktzahl_Pin1, char Punktzahl_Pin2, char Reset_Pin);

/* -------------------------------------------------------------------------------- */

/* Hauptprogramm =================================== */

void loop(){

Zuruecksetzung(P_S1, P_S2, R_S);

/* AP3. ------------------------------------------------------------------------- */

Start_Taster(S_S);

for(a = 0; a < 3; a++){ // Optische Meldung ausgeben

Blinken();

}

/* -------------------------------------------------------------------------------- */

/* AP7. ------------------------------------------------------------------------- */

do{

/* AP4. ------------------------------------------------------------------------- */

Zufallszahl = random(100);

if(Zufallszahl %2 == 0){

EingangSpieler[0] = Q_S1;

EingangSpieler[1] = Q_S2;

Zms[0] = O_M1;

Zms[1] = O_M2;

Spieler[0] = 1;

Spieler[1] = 2;

}

else{

EingangSpieler[0] = Q_S2;

EingangSpieler[1] = Q_S1;

Zms[0] = O_M2;

Zms[1] = O_M1;

Spieler[0] = 2;

Spieler[1] = 1;

}

/* -------------------------------------------------------------------------------- */

Die Unterprogramme «Start_Taster», «Blinken» & «Zuruecksetzung» werden deklariert.
Diese Funktionen werden im Programm mehrmals verwendet. Um den benötigten Speicher zu verkleinern werden Unterprogramme erstellt.

Das Hauptprogramm befindet sich in der Funktion «loop()». Diese wird ständig wiederholt.

AP3. führt «Start_Taster» aus. Danach wird «Blinken» drei mal ausgeführt.

AP4. generiert zunächst eine Zufallszahl zwischen 0 und 99.

Abhängig davon, ob die Zahl gerade oder ungerade ist werden die Arrays «EingangSpieler», «Zms» & «Spieler» einem Wert zugeordnet.

/* AP5. ------------------------------------------------------------------------- */

for(x = 0; x < 2; x++){

Zufallszeit = random(4001);

Anfangszeit = millis();

do{

Spielersignal = digitalRead(EingangSpieler[x]);

Zeit = millis();

if(Zeit >= Anfangszeit + Zufallszeit+ 1000){

digitalWrite(Zms[x], HIGH);

}

}while(Spielersignal == 0);

Endzeit = millis();

if(Endzeit >= Anfangszeit+ Zufallszeit + 1000){

Reaktionszeit = Endzeit – Anfangszeit – Zufallszeit – 1000;

}

else{

Reaktionszeit = 10000;

for(c = 0; c <2; c++){

Blinken();

}

}

if(Spieler[x] == 1){

Re_Ze1 = Reaktionszeit;

}

else{

Re_Ze2 = Reaktionszeit;

}

digitalWrite(Zms[x], LOW);

}

/* -------------------------------------------------------------------------------- */

AP5. führt die Zeitmessung durch. Diese wird zwei Mal wiederholt.

Zunächst wird eine Zufällige Zahl zwischen 0 und 4000 generiert.

Danach wird der Messvorgang durchgeführt..

Zuletzt wird die Reaktionszeit dem entsprechenden Spieler zugeordnet.

/* AP6. ------------------------------------------------------------------------- */

if(Re_Ze1 > Re_Ze2){

digitalWrite(P_S2, HIGH);

delay(100);

digitalWrite(P_S2, LOW);

Pu_Za2++;

}

else if(Re_Ze2 > Re_Ze1){

digitalWrite(P_S1, HIGH);

delay(100);

digitalWrite(P_S1, LOW);

Pu_Za1++;

}

/* -------------------------------------------------------------------------------- */

/* AP7. ------------------------------------------------------------------------- */

}while(Pu_Za1 < 9 && Pu_Za2 < 9);

if(Pu_Za1 == 9){

digitalWrite(O_M1, HIGH);

}

else{

digitalWrite(O_M2, HIGH);

}

/* -------------------------------------------------------------------------------- */

/* AP8. ------------------------------------------------------------------------- */

Start_Taster(S_S);

digitalWrite(O_M1, LOW);

digitalWrite(O_M2, LOW);

Zuruecksetzung(P_S1, P_S2, R_S);

Pu_Za1 = 0; // Punktzahl1 zuruecksetzen

Pu_Za2 = 0; // Punktzahl2 zuruecksetzen

/* -------------------------------------------------------------------------------- */

}

/* ================================================= */

AP6. wertet die Reaktionszeiten aus und vergibt dem Spieler mit der kleineren Reaktionszeit einen Punkt.

AP7. führt den gesamten Ablauf durch, bis einer der Spieler neun Punkte besitzt.

AP8. führt zunächst «Start_Taster» aus. Danach werden die Ausgänge «O_M1» & «O_M2» auf logisch LOW gesetzt. Anschliessend wird «Zuruecksetzung» ausgeführt und die Punkte der Spieler werden genullt.

/* Unterprogrammdefinition --------------------------------------------- */

// Start-Signal einlesen

void Start_Taster(char Start_Pin){

do{

St_Si = digitalRead(Start_Pin);

delay(50);

}while(St_Si == 0);

}

// Optische Meldung ein- & ausschalten

void Blinke(void){

for(b = 1; b > -1; b--){

delay(500);

digitalWrite(O_M1, b);

digitalWrite(O_M2, b);

}

}

// Anzeigen zuruecksetzen

void Zuruecksetztung(char Punktzahl_Pin1, char Punktzahl_Pin2, char Reset_Pin){

digitalWrite(Reset_Pin, LOW);

for(y = 1; y > -1; y--){

delay(100);

digitalWrite(Punktzahl_Pin1, y);

digitalWrite(Punktzahl_Pin2, y);

}

digitalWrite(Reset_Pin, HIGH);

}

/* -------------------------------------------------------------------------------- */

«Start_Taster» liest den Wert an «Start_Pin» solange ein, solange der Wert null entspricht. Danach wird das Programm verlassen.

«Blinken» schaltet die Ausgänge «O_M1» und «O_M2» zunächst ein, wartet 500 Milli-Sekunden und schaltet diese wieder aus.

«Zuruecksetzung» setzt den Ausgang «Reset_Pin» auf logisch LOW. Danach wird aus den Ausgängen «Punktzahl_Pin1» & «Punktzahl_Pin2» ein HIGH-Impuls ausgegeben. Zuletzt wird der «Reset_Pin» auf logisch HIGH gesetzt.

# 6. Verwendete Geräte

Multimeter: Agilent U1242A, BERUF Zug 03542

Speisegerät: DC Power Supply DF1730SB3A, BERUF Zug 03460

Breadboard: Besitzer Thomas Ammann

Digitrainer 6 BERUF Zug 00878

Arduino Uno Rev.3

# 7. Stückliste und Kosten

Bauteil | Typ/Wert | Menge | Kosten pro Stk. in Fr. | Artikelnummer | Lieferant
LED | Rot LED 5mm | 2 | 0.29 | LED 5MM 12V RT | Reichelt
Taster | Drucktaster | 3 | 1.30 | SDT 21SP
IC | 74HC163 | 2 | 0.28 | 74HCT 163
| 74HC4511 | 2 | 0.68 | 74HC 4511
7-Segment Anzeige | HDSP 5503 | 2 | 0.78 | SC 52-11 GE
Widerstand | Metallschicht Widerstände R1=R2=430Ω | 2 | 0.08 | METALL 430
| Metallschicht Widerstände R3-R16=620Ω | 14 | 0.08 | METALL 620
| Metallschicht Widerstände R17-R19=10kΩ | 3 | 0.08 | METALL 10,0K
Mikrokontroller | Arduino UNO Rev.3 | 1 | 18.05 | ARDUINO UNO
Rasterplatine | Streifenrasterplatine | 1 | 1.48 | H25SR160

*Die Versandkosten von Reichelt betragen 7.16 Franken.

Total: 29.01 CHF

# 8. Schlussfolgerung

Das Projekt ist im Zeitrahmen durchgeführt worden. Die Zeitplanung konnte grösstenteils eingehalten werden und ist plangemäss abgeschlossen worden.
Die entworfene Feinplanung musste für AP4. & AP5. erweitert werden. Dies ermöglichte eine einfachere Durchführung der beiden Arbeitspakete.
Die 7-Segment-Anzeigen werden mit BCD-UP-Counter und BCD-to-7-Segment-Converter angesteuert.

## 8.1 Verbesserungsmöglichkeiten

1. 7-Segment-Ansteuerung

Die Ansteuerung der 7-Segment-Anzeigen erfolgt mit BCD-UP-Counter und BCD-to-7-Segment-Converter. Dies schränkt die Anzeige-Möglichkeiten ein. Mit, vom Arduino angesteuerten, Schieberegistern könnten die 7-Segment-Anzeigen vielseitiger genutzt werden.

# 9. Quellenverzeichnis

Hardware:

LED rot 5mm:
http://www.produktinfo.conrad.com/datenblaetter/175000-199999/184543-da-01-en-LED_20_5mm_rot_WU_8_53_HD.pdf, 15.05.2017

Arduino UNO Rev. 3 Spezifikationen:

https://www.arduino.cc/en/Main/arduinoBoardUno, 15.05.2017

74HC162:

http://pdf.datasheetcatalog.com/datasheet/philips/74HC162.pdf, 15.05.2017

74HC4511:

https://www.sparkfun.com/datasheets/IC/74HC4511.pdf, 15.05.2017

7-Segment:

http://www.alldatasheet.com/datasheet-pdf/pdf/64675/HP/HDSP-5503.html, 15.05.2017

Software:

Struktogrammer:

https://www.zg.ch/behoerden/volkswirtschaftsdirektion/gibz/grundbildung/02-technik-informatik/informatiker-in-efz

Arduino-Software:

https://www.arduino.cc/en/Main/Software

# 10. Identifikation

Zug, 30.05.2017

Unterschriften:

Seite 4 von 46
