YodaCh96/Reaktionsspiel/doc/AP6x.docx

Reaktionsspiel

AP-Nummer: 6

AP-Titel: Zeitmessung-Auswertung

AP-Verantwortlicher: Ioannis Christodoulakis, Thomas Ammann
Datum: 29. Mai 2017

Raumtemperatur: 24.4 °C
Revision: 01

# 1. Zusammenfassung

Es wurde ein Software-Programm entwickelt, welches die Reaktionszeiten zweier Spieler vergleicht und auswertet. Derjenige Spieler mit der kleineren Reaktionszeit erhält einen Punkt.

# 2. Aufgabenstellung

Die Reaktionszeiten der Spieler werden verglichen. Der Spieler mit der kürzeren Reaktionszeit erhält einen Punkt.

Die Punktzahl der Spieler wird aus je einem Controllerausgang bestimmt. Das Punktzahl-Signal ist ein HIGH-Impuls, welcher auftritt, wenn die Punktzahl um einen Punkt erhöht werden soll.

2.1 Schnittstelleninformationen

Eingabe | Ausgabe
Reaktionszeit1 | Punktzahl-Signal1
Reaktionszeit2 | Punktzahl-Signal2
| Punktzahl1
| Punktzahl2

# 3. Begriffserklärung

Variable | Speicher-Name
Punktzahl1 | Pu_Za1
Punktzahl2 | Pu_Za2
Reaktionszeit1 | Re_Ze1
Reaktionszeit2 | Re_Ze2

Ausgabe | Speicher-Name | Pin-Name | Pin
Punktzahl-Signal1 | Pu_Si1 | P_S1 | 6
Punktzahl-Signal2 | Pu_Si2 | P_S2 | 7

# 4. Struktogramm


# 5. Programm–Code

Zunächst werden die Variablen definiert.

int Re_Ze1, // Variablen

Re_Ze2 ;

char Pu_Za1 = 0,

Pu_Za2 = 0 ;

Die Pin-Nummern der Ein- und Ausgänge sind den Pin-Namen gespeichert. Diese sind unveränderbar.

const char P_S1 = 6, // Konstanten

P_S2 = 7;

setup() wird einmalig beim Einschalten des Arduino ausgeführt. Dort definieren wir mit der Funktion pinMode(), ob die digitalen Pins Ein- oder Ausgänge sind.

void setup() { // I/O

pinMode(P_S1, OUTPUT); // Ausgaenge

pinMode(P_S2, OUTPUT);

}

loop() wird wiederholt ausgeführt. In der Funktion wird das Hauptprogramm ausgeführt.
Die if-Verzweigung prüft, ob «Re_Ze1» grösser als «Re_Ze2» ist. Trifft dies zu wird ein Punktzahl-Signal ausgegeben und die Punktzahl des ersten Spielers wird inkrementiert. Die else-if-Verzweigung prüft, ob «Re_Ze1» kleiner als «Re_Ze2» ist. Trifft dies zu wird ein Punktzahl-Signal ausgegeben und die Punktzahl des zweiten Spielers wird inkrementiert.

void loop() { // Hauptprogramm

if(Re_Ze1 > Re_Ze2){ // Auswertung

digitalWrite(P_S2, HIGH);

delay(100);

digitalWrite(P_S2, LOW);

Pu_Za2++;

}

else if(Re_Ze1 < Re_Ze2){

digitalWrite(P_S1, HIGH);

delay(100);

digitalWrite(P_S1, LOW);

Pu_Za1++;

}

# 6. Verwendete Programme

- Arduino Software
- Struktogrammer

# 7. Schlussfolgerung

Das entwickelte Software-Programm erfüllt die Anforderungen der Aufgabenstellung
(2. Aufgabenstellung/Seite 2).

# 8. Identifikation

Ort, Datum: ________________________

Unterschrift: _______________________ Unterschrift: _______________________
Ioannis Christodoulakis Thomas Ammann
