YodaCh96/Reaktionsspiel/plan/Blockschaltbild.docx

Signal-Element

Vcc

Taster1

Taster2

Start-Taster

Arduino Uno

Optisches Signal-Baustein

Anzeige-Baustein

Signal-Element

Anzeige2

Anzeige1

GND
