YodaCh96/Reaktionsspiel/hw/Gesamtschaltung.docx

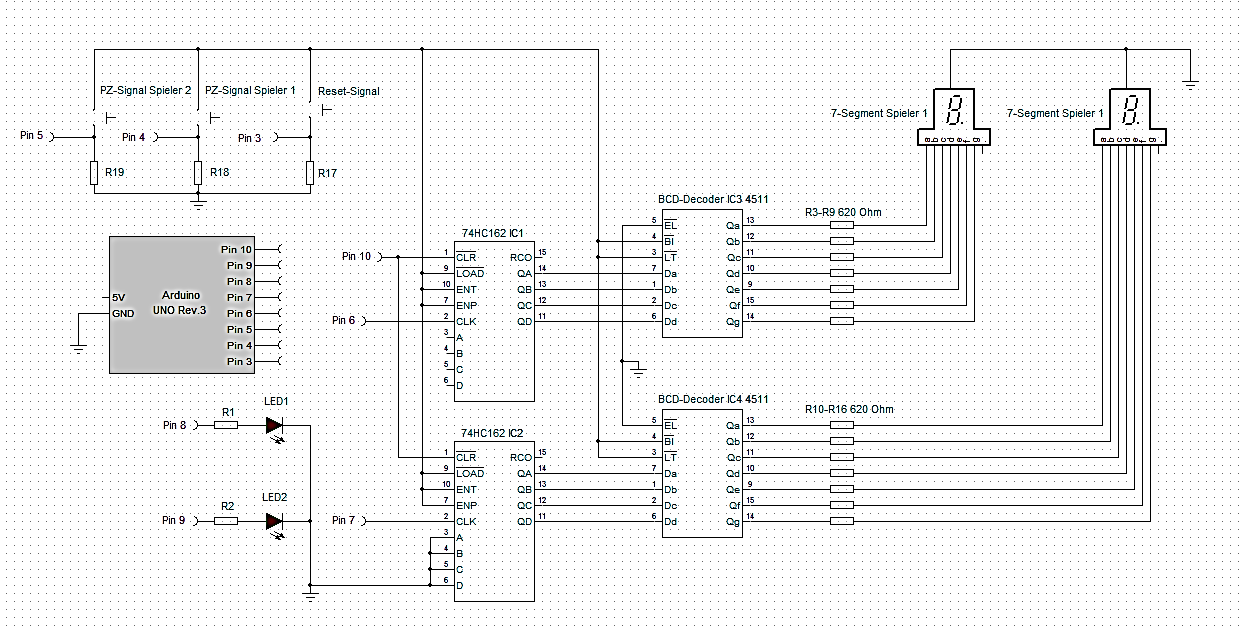
[picture p12: figure]
